deton/toiletled/README.markdown

# トイレ使用中表示ランプ

会社のトイレ前に置く、個室が全て使用中かどうかを表示するLEDです。

toiletled写真

その階の全個室が使用中の場合は赤LEDを点灯します
(電車のトイレの使用中ランプと同様)。

* トイレのドアを開けなくても、個室が全て使用中かどうかわかる
* どの階に空きがあるかが表示されるので、
  今いる階が全て使用中の場合に、上と下のどちらの階に向かえばいいかわかる

最近、他の部の人が、各個室の使用中状況をWebで取得できるようにしてくれました
(ドアとドア枠にリードスイッチ、TWE-Lite、Raspberry Piを使っている模様)。

自席PCやスマホのWebブラウザで確認できて便利になったのですが、
確認せずに席を立ってしまったり、トイレまで移動する間に状況が変わる場合もあって、
結局トイレのドアを開けて確認することが多く、
トイレ前に使用中かどうかを表示するモノがあると便利そうだったので作成。

全て使用中の場合、他の階に行くことになるのですが、
上の階に行くか下の階に行くか判断したいので、他の階の使用中状況も表示します。

WiFi接続して2秒おきに状況取得を行います。

## 各種バージョン
以下の順で改良しながら何種類か作成しました。

* Wi-Fi版(Linino ONE使用)
 + [赤色LED版](redled)
 + [フルカラーLED版](fullcolorled)
* BLE版
 + [BLESerial版](bleserial)
 + [BLE版(mbed HRM1017使用)](ble)
 + [BLEアドバタイズ版(BLE nano使用)](bleadv)
* TWE-Lite(ZigBee)版
 + [TLC5940版](twelite)
 + [PCA9622版](twelite#twe-litepca9622版)
