deton/toiletled/(commit log)

2015-03-26 init()やmain()を関数化。 関数とそれ以外がまざっているとわかりにくいので。
2015-03-26 HTTPによる状態取得時エラーで停止しないようにした。 WiFiが不安定になった時に停止すると困るので。
2015-03-28 不要なループを削除してコードを単純化
2015-03-29 /etc/config/dhcpがdnsmasqサーバ用設定ファイルであることを記述。 ファイル名だけだとDHCPサーバの設定と思われそうなので。
2015-03-29 改良案に、センシング側との統合を追加
2015-03-30 改良案追加:HTTPによる状況取得失敗時表示
2015-04-02 HTTPによる状況取得失敗時ログ出力に日時追加。
2015-04-12 フルカラーLED版追加
2015-04-12 フルカラーLED版写真を埋め込み
2015-04-12 フルカラーLED版写真埋め込み位置を移動。
2015-04-16 Linux側から5秒以上指示が無かったらLEDを消す。 WiFi切断時等点灯のままにならないように。
2015-04-17 読み取ったコマンドが正しくない形式の場合は無視。 Linux側をhaltしてしばらくすると変な文字が読み取られて 一部赤点灯する場合があるのを回避するため。
2015-05-02 READMEに、フルカラーLED版(Type2)追加。
2015-05-14 フルカラーLED版(Type2)用にLEDの並びを上下反転。
2015-05-14 空き2や3の時に薄く黄色にするのをやめた。 横から見た時に黄色が見立つので、空き1の場合と区別がつきやすいように、 空き2や3は緑だけに変更。
2015-05-30 HTTP GET時にtimeout指定を追加。 timeout等でHTTP GET失敗時は通常の2秒でなく1秒後に再リクエスト。
2015-05-30 自階のLEDを明るく、他の階のLEDを暗く表示。 近くからずっと見ることは無く、遠くから見えた方がいいので全体的に明るめに変更。
    空き2つ以上の色を緑から青に変更。
    Web上の表示と合わせるためと、緑と赤は見分けにくい人がいるかもしれないので。
    空き2つ以上で薄く黄色がかった色にするのをやめた。
    横から見ると赤LED点灯が見えて本当の黄色とぱっと区別がしにくいので。
2015-06-05 Linux側からArduino側へは、各LEDの色を指定するように変更。 従来はLinux側からは空き個室数を指定して、Arduino側で色を決めていた。 が、色は細かく調整したい(自階と他階の明るさのバランス調整等)。 いちいちArduino側を書き換えるのは面倒。 Linux側のPythonスクリプトを書き換える方が楽。
    自階に空きが無い場合、他階の情報が重要になるので、他階を明るめに表示。
2015-06-26 1時間以上使用中のままの個室がある場合は点滅表示。 電池切れ等によりセンサが変な状態になっている場合に発生することがあるので、 表示が正しくない可能性があることを示すため。
2015-09-27 設置されている階を点滅表示。遠くから見た時に判別しやすいように。
2015-10-17 BLE版はBLESerial版に名前変更。
2015-10-25 BLE版とBLEアドバタイズ版を追加
2015-10-25 BLESerial版のREADME更新、バグ修正
2015-10-25 BLE版等のimgへのリンク先修正
2015-10-25 READMEで、BLEを使う版同士のリンクを作成
2015-10-25 README中のmbedサイトのToiletLED_observerへのリンク先修正。
2015-10-26 BLEアドバタイズ版現場写真を埋め込み。トップにBLE版へのリンクを追加
2015-10-28 README更新: BLE版でばらばらのLEDを使っている理由追記
2015-11-03 トイレ使用中状況JSONレスポンスに特定階が全く含まれない場合unknownにする
    空き2つ以上ありとみなすのではなくて。
2015-11-18 Pythonからの移植時に一部変数をグローバル変数にしてしまっていたバグを修正。
    decideReqChar()をfunctionとして抽出した際に、
    変数名の引数名への変更が一部漏れていたのを修正。
2015-11-21 TWE-Lite版を追加
2015-11-21 夜間は対象階近くの階のLEDも点灯。
    夜間に省電力のため対象階のLEDだけ点滅させると、
    消費電流が小さすぎてモバイルバッテリが自動オフするので。
2015-11-21 夜間に省電力のため点灯LEDを減らすのをやめた
    センサ異常やセンサバッテリが無くなってunknown状態になると消灯するので、
    近くの階用LEDを点灯しているつもりでも消灯になっていて、
    モバイルバッテリが自動オフになる場合があるので。
    モバイルバッテリがオフになると、手でオンにしないと復活できないので。
2015-11-21 TWE-Lite(親機、子機)用ファームウェアのソース生成スクリプト追加
2015-11-21 トップのREADMEにTWE-Lite版へのリンクを追加
2015-11-22 Edison+TWE-Lite側のpyserial等のインストールに関する記述を追加
2015-11-22 TWE-Lite版README更新: microUSB->3.3V変換アダプタを部品リストに追加
2015-11-23 TWE-Lite+PCA9622版を追加
2015-11-23 参考リンク追加
2015-11-24 TWE-Lite版README更新: NiMH電池構成も追加
2015-11-24 TWE-Lite版README更新: 3段目itemizeが効いていないのを修整
2016-01-16 電池消費を抑えるため、夜間はTWE-Lite子機をsleepさせるコマンドを送信
2016-01-16 TWE-Lite+PCA9622版を省電力のため夜間はsleepさせるコマンドに対応
2016-01-30 README構成を整理。赤色LED版とフルカラーLED版の記述をサブフォルダに移動
    トイレドア横に付ける版のTWE-Lite+PCA9622版の写真を追加
2016-01-31 TWE-Lite+PCA9622版の部品にUEW線を追加
2016-02-01 TWE-Lite版を電池消費を抑えるため休日はsleepさせるようにした
2016-02-11 Add sample response JSON file
